oturpe/horse-power-fuel-cell/hardware/fuel-cell-monitor.kicad_pcb

## KiCad design hardware/fuel-cell-monitor.kicad_pcb (2016-11-29)

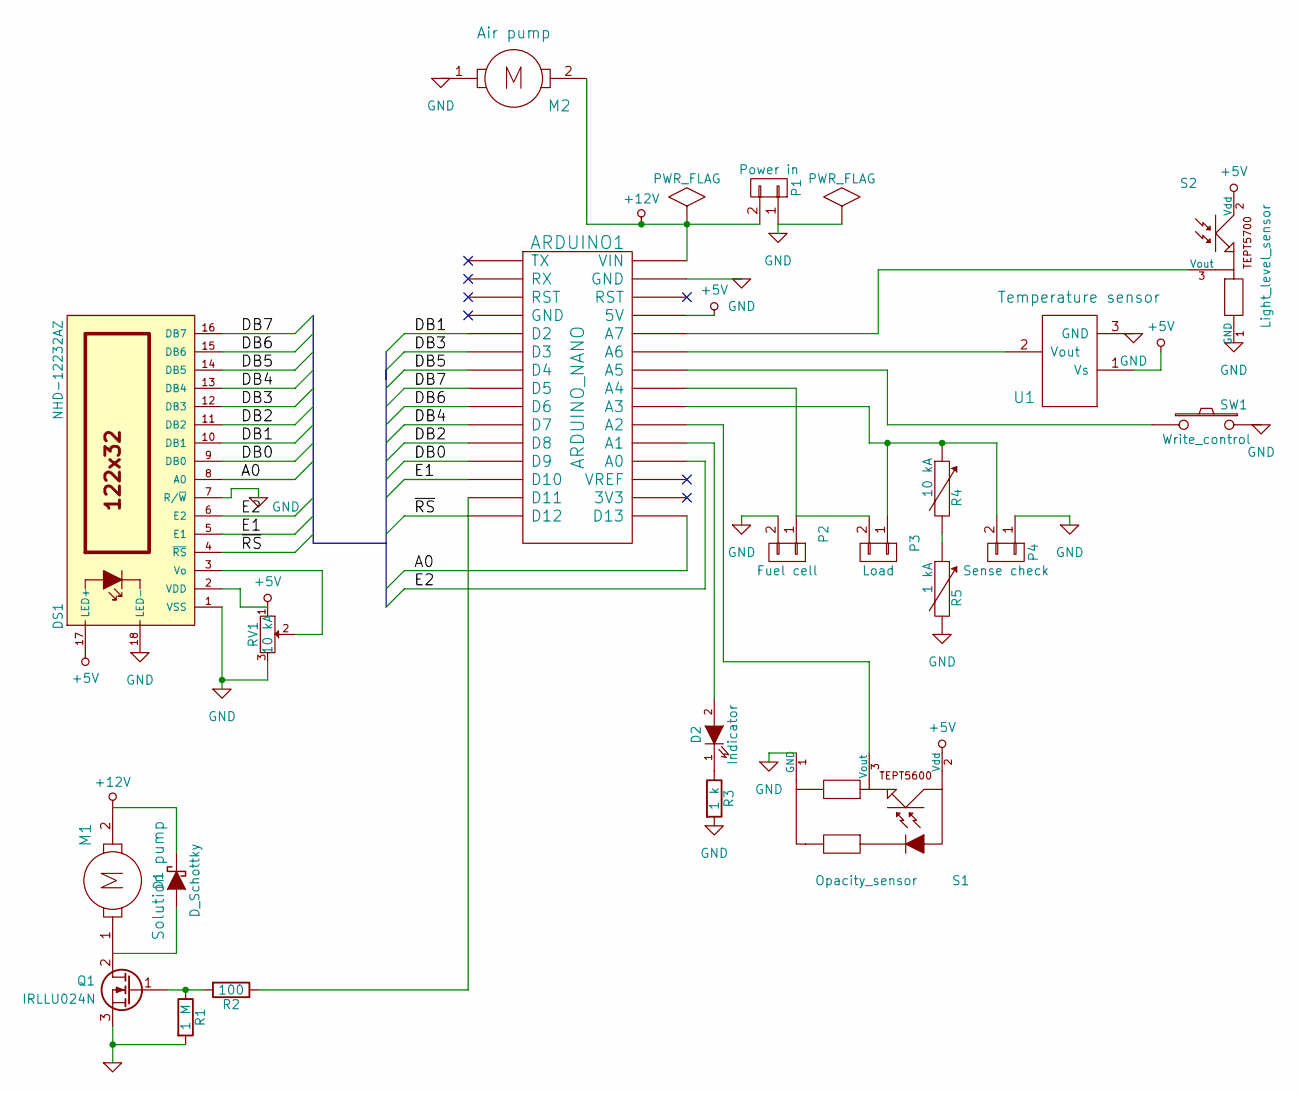
[picture p1: schematic fuel-cell-monitor.sch]

Parts:
ARDUINO1: ARDUINO_NANO; arduino_nano_header
D1: D_Schottky; Diode_DO-35_SOD27_Horizontal_RM10
D2: Indicator; LED-5MM
DS1: NHD-12232AZ; IDC_Header_Straight_20pins
M1: Solution pump; Big_green_chocolate_1x2
M2: Air pump; Big_green_chocolate_1x2
P1: Power in; Big_green_chocolate_1x2
P2: Fuel cell; Big_green_chocolate_1x2
P3: Load; Big_green_chocolate_1x2
P4: Sense check; PINHEAD1-2
Q1: IRLLU024N; TO-251AA
R1: 1 M; Resistor_Horizontal_RM10mm
R2: 100; Resistor_Horizontal_RM10mm
R3: 1 k; Resistor_Horizontal_RM10mm
R4: 10 kA; Trimmer_ACP_*V10
R5: 1 kA; Trimmer_ACP_*V10
RV1: 10 kA; Trimmer_ACP_*V10
S1: Opacity_sensor; Big_green_chocolate_1x3
S2: Light_level_sensor; Big_green_chocolate_1x3
SW1: Write_control; SW_PUSH_6mmx6mm
U1: Temperature sensor; Big_green_chocolate_1x3

Connections:
+5V: ARDUINO1.27 (5V), DS1.2 (VDD), DS1.17 (LED+), RV1.1, S1.2 (Vdd), S2.2 (Vdd), U1.1 (Vs)
+12V: ARDUINO1.30 (VIN), D1.1 (K), M1.2, M2.2, P1.2
/A0: ARDUINO1.16 (D13), DS1.8 (A0)
/DB0: ARDUINO1.12 (D9), DS1.9 (DB0)
/DB1: ARDUINO1.5 (D2), DS1.10 (DB1)
/DB2: ARDUINO1.11 (D8), DS1.11 (DB2)
/DB3: ARDUINO1.6 (D3), DS1.12 (DB3)
/DB4: ARDUINO1.10 (D7), DS1.13 (DB4)
/DB5: ARDUINO1.7 (D4), DS1.14 (DB5)
/DB6: ARDUINO1.9 (D6), DS1.15 (DB6)
/DB7: ARDUINO1.8 (D5), DS1.16 (DB7)
/E1: ARDUINO1.13 (D10), DS1.5 (E1)
/E2: ARDUINO1.19 (A0), DS1.6 (E2)
/~RS: ARDUINO1.15 (D12), DS1.4 (~RS)
GND: ARDUINO1.29 (GND), DS1.1 (VSS), DS1.7 (R/~W), DS1.18 (LED-), M2.1, P1.1, P2.2, P4.1, Q1.3 (S), R1.2, R3.2, R5.2, RV1.3, S1.1 (GND), S2.1 (GND), SW1.2, U1.3 (GND)
unnamed: ARDUINO1.14 (D11), R2.1
unnamed: ARDUINO1.20 (A1), D2.2 (A)
unnamed: ARDUINO1.21 (A2), S1.3 (Vout)
unnamed: ARDUINO1.22 (A3), P3.1, P4.2, R4.1
unnamed: ARDUINO1.23 (A4), P2.1, P3.2
unnamed: ARDUINO1.24 (A5), SW1.1
unnamed: ARDUINO1.25 (A6), U1.2 (Vout)
unnamed: ARDUINO1.26 (A7), S2.3 (Vout)
unnamed: D1.2 (A), M1.1, Q1.2 (D)
unnamed: D2.1 (K), R3.1
unnamed: DS1.3 (Vo), RV1.2
unnamed: Q1.1 (G), R1.1, R2.2
unnamed: R4.2, R5.1

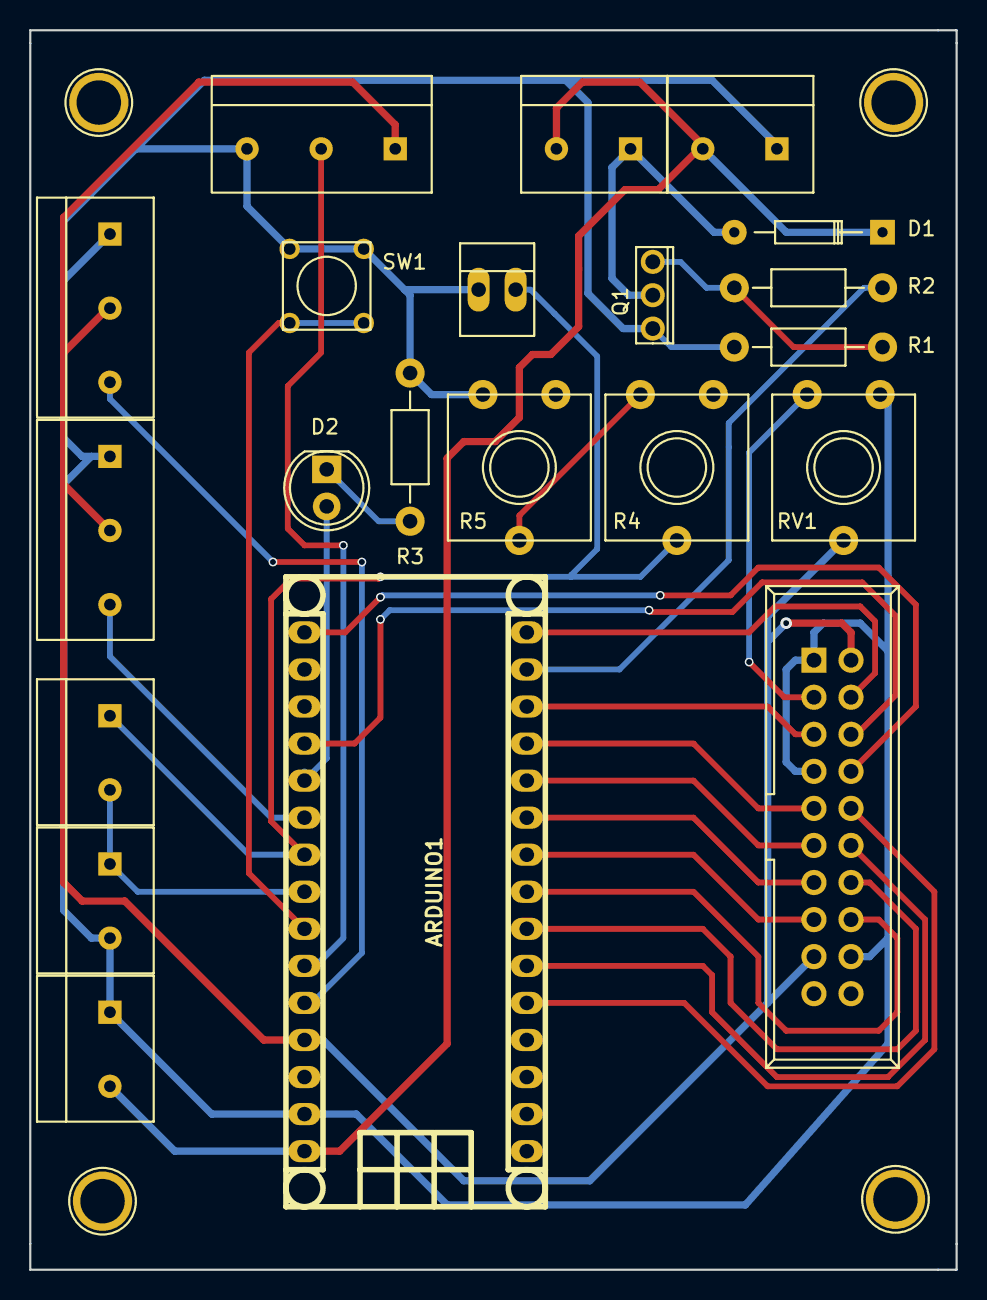
[picture p2: board fuel-cell-monitor.kicad_pcb from above]

Board: 2 copper layers, 63.5 x 85.0 mm, 21 parts (0 on the bottom side), 28 nets.
