oturpe/horse-power-fuel-cell/config-transient.h

// Configuration for measuring transient effects for a short period of time.
// Captures about 30 seconds of data.

// How many samples to average for each reading
#define SAMPLE_COUNT 10
// How long to wait between samples
#define SAMPLE_INTERVAL 100

// How often measurements are taken. Given in units of millisecond.
#define MEASUREMENT_WRITE_INTERVAL 1000L
