oturpe/horse-power-fuel-cell/(commit log)

2016-11-16 First version
    Starts recording, stops recording and outputs readings already.
    Some small problems remain.
    [fuel-cell-monitor.kicad_pcb, fuel-cell-monitor.sch]
2016-11-17 Upgraded version
    [fuel-cell-monitor.sch]
2016-11-22 Add multiple things to schematic
    [fuel-cell-monitor.sch]
2016-11-23 Add missing parts to schematics
    [fuel-cell-monitor.sch]
2016-11-23 Use whole dac range for voltage and ambient light measurement
2016-11-24 Add .gitignore ignoring kicad temporary files
2016-11-24 Fix problems found with KiCad electrical rules check
    [fuel-cell-monitor.sch]
2016-11-28 Add code for opacity sensor + fix bug with output block number printout
    [fuel-cell-monitor.ino]
2016-11-28 Fix remaining small things with the printed circuit board
    This included making the default trace 0.40 mm wide just be sure
    and fixing trimmer and potetiometer footprints.
    [fuel-cell-monitor.kicad_pcb, fuel-cell-monitor.sch]
2016-11-28 Fix potentiometer and trimmer footprint
    [fuel-cell-monitor.kicad_pcb, fuel-cell-monitor.sch]
2016-11-29 Add solution pump control code
2016-11-29 Final fixes before ordering pcbs.
    Most notably solution pump driver mosfet had to be changed. The earlier
    specified type did not work.
    [fuel-cell-monitor.kicad_pcb, fuel-cell-monitor.sch]
2016-12-12 Fix pins to match pcb, and add temperature sensor code
    [config-transient.h, fuel-cell-monitor.ino]
2016-12-14 Add more pcb problems
2016-12-15 Implement printing of values in the screen
2016-12-16 Add forgotten screen files, plus change to show screen as flipped
    [fuel-cell-monitor.ino, screen-ascii-maps.h, screen.h]
2016-12-16 Coarse calibration of ambient light sensor
2016-12-16 Shorten solution pump on time
    [fuel-cell-monitor.ino]
2017-01-03 Fix mean and transient recording intervals
    They are now one hour and one second, respectively
    [config-mean.h, config-transient.h, fuel-cell-monitor.ino]
